MigueelS/sensinginmotion/images/6 pin set.png

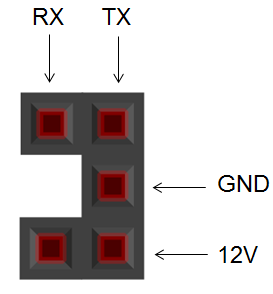
images/6 pin set.png
