MigueelS/sensinginmotion/images/gps protocol.png

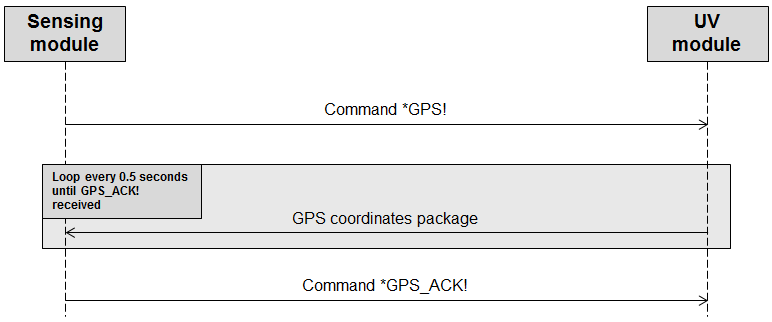
images/gps protocol.png
