MigueelS/sensinginmotion/images/System schematic.png

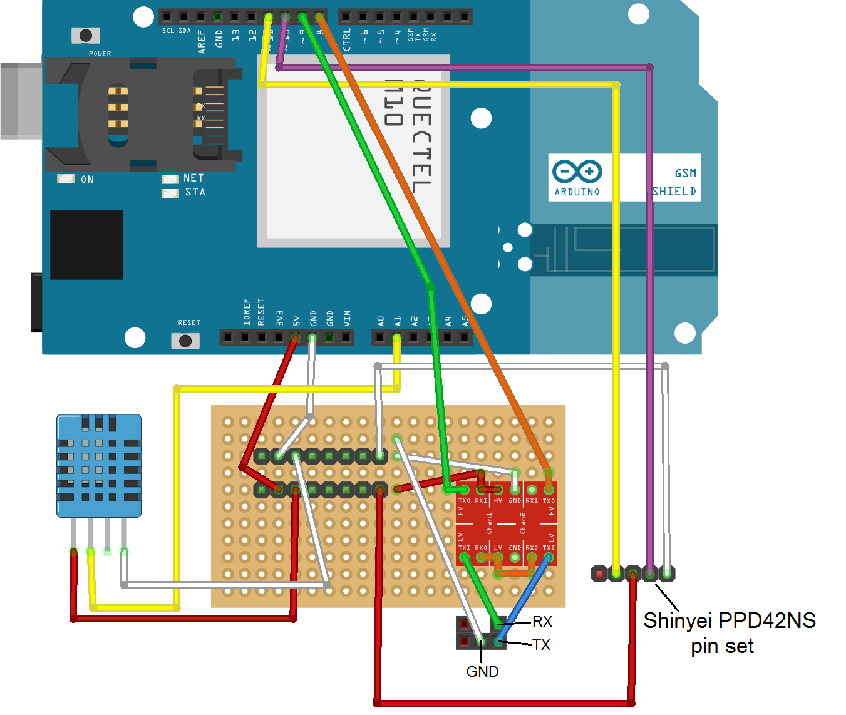
images/System schematic.png
