MigueelS/sensinginmotion/images/manual controls.png

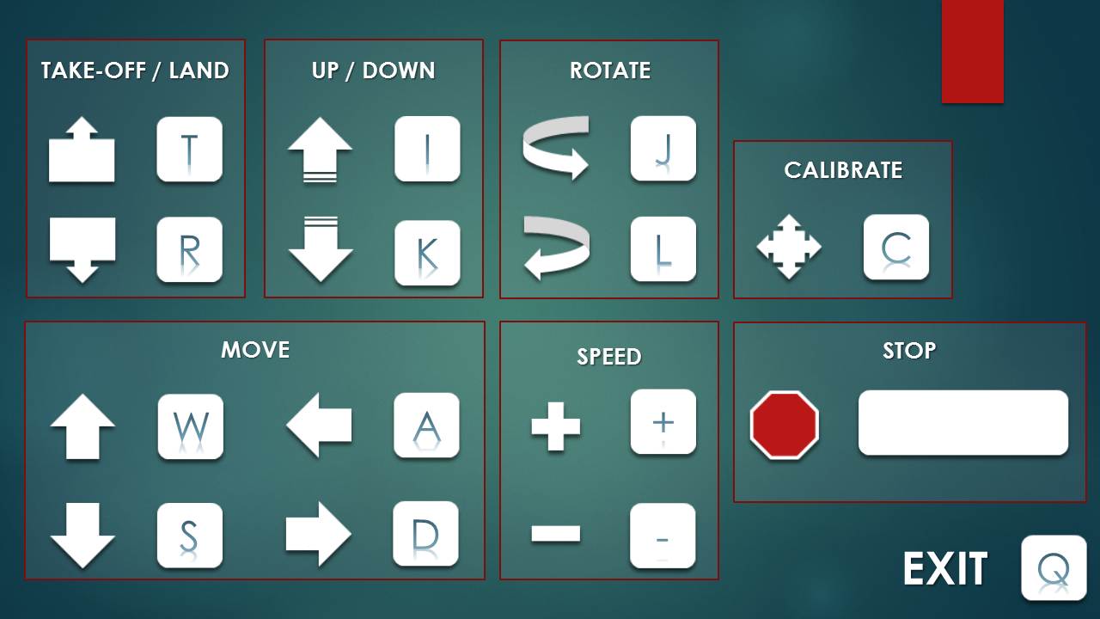
images/manual controls.png
