MigueelS/sensinginmotion/(commit log)

2014-09-07 pin set diagram added
2014-09-07 Arduino code added
